FilipMen/Scientific_instrumentation/Interface/guiLoop.py

## MIT License
##
## Copyright 2014 Nicco Kunzmann
##
## Permission is hereby granted, free of charge, to any person obtaining a copy of this
## software and associated documentation files (the "Software"), to deal in the Software
## without restriction, including without limitation the rights to use, copy, modify, merge,
## publish, distribute, sublicense, and/or sell copies of the Software, and to permit persons
## to whom the Software is furnished to do so, subject to the following conditions:
##
## The above copyright notice and this permission notice shall be included in all copies
## or substantial portions of the Software.
##
## THE SOFTWARE IS PROVIDED "AS IS", WITHOUT WARRANTY OF ANY KIND, EXPRESS OR IMPLIED,
## INCLUDING BUT NOT LIMITED TO THE WARRANTIES OF MERCHANTABILITY, FITNESS FOR A PARTICULAR
## PURPOSE AND NONINFRINGEMENT. IN NO EVENT SHALL THE AUTHORS OR COPYRIGHT HOLDERS BE LIABLE
## FOR ANY CLAIM, DAMAGES OR OTHER LIABILITY, WHETHER IN AN ACTION OF CONTRACT, TORT OR
## OTHERWISE, ARISING FROM, OUT OF OR IN CONNECTION WITH THE SOFTWARE OR THE USE OR OTHER
## DEALINGS IN THE SOFTWARE.
"""
guiLoop lets you use while and for loops with GUIs.
Usually using loops in GUIs makes them block.
This module uses the yield statement in loops to let the GUI update while the loop is still running.
See the example.py or start_and_stop.py for examples.
The code is available here: https://gist.github.com/niccokunzmann/8673951#file-guiloop-py
Currently only tkinter is supported but with a little help this can be adapted to other GUI frameworks, too.
Change the function _start_in_gui for different GUI frameworks.
If you use this code for an other GUI than tkinter send me your code or
leave a comment so that some day this can become a module on pypi.python.org
useful for others, too.
This was created because of an stackoverflow question:
    http://stackoverflow.com/questions/21411748/python-how-do-i-continuously-repeat-a-sequence-without-a-while-loop-and-still
    
"""

def use_tkinter_after(gui_element, wait_time, call_this):
    # the following line needs replacement depending on the GUI
    # it calls 'call_this' after a period of time 'wait_time' in ms
    # for Tkinter
    gui_element.after(wait_time, call_this)

def use_PyQt5_QTimer(gui_element, wait_time, call_this):
    from PyQt5.QtCore import QTimer
    QTimer.singleShot(wait_time, call_this)

def use_any_timer(gui_element, wait_time, call_this):
    if hasattr(gui_element, 'after'):
        use_tkinter_after(gui_element, wait_time, call_this)
    elif hasattr(gui_element, 'pyqtConfigure'):
        use_PyQt5_QTimer(gui_element, wait_time, call_this)
    else:
        raise TypeError("Can not automatically detect which GUI this is.")

def _loop_in_the_gui(gui_element, generator, _start_in_gui):
    try:
        # generator yields the time to wait
        wait_time = next(generator)
    except StopIteration:
        pass
    else:
        if wait_time is None:
            # yield
            wait_time = 0
        else:
            # yield seconds
            wait_time = int(wait_time * 1000) # Tkinter works with milli seconds
        call_this_again = lambda: _loop_in_the_gui(gui_element, generator,
                                                   _start_in_gui)
        _start_in_gui(gui_element, wait_time, call_this_again)

class guiLoop(object):
    
    def __init__(self, function, start_in_gui = use_any_timer):
        """make a function to a guiLoop function
        The resulting function needs a gui element as first argument."""
        self.function = function
        self.__doc__ = function.__doc__
        self.__name__ = function.__name__
        self.start_in_gui = start_in_gui

    def __call__(self, gui_element, *args, **kw):
        generator = self.function(*args, **kw)
        _loop_in_the_gui(gui_element, generator, self.start_in_gui)
        return generator

    def __get__(self, gui_element, cls):
        if gui_element is None:
            return self
        return lambda *args, **kw: self(gui_element, gui_element, *args, **kw)
        

def tkLoop(function):
    """a guiLoop for tkinter"""
    return guiLoop(function, use_tkinter_after)

def qt4Loop(function):
    """a guiLoop for PyQt5"""
    return guiLoop(function, use_PyQt5_QTimer)

class StopLoopException(Exception):
    """This is raised if the loop shall stop"""
    pass

def stopLoop(generator):
    """stop the loop
    Generator is the return value of guiLoop."""
    try: generator.throw(StopLoopException())
    except StopLoopException: pass

__all__ = ['guiLoop', 'stopLoop', 'StopLoopException', 'tkLoop', 'qt4Loop']
